lpodkalicki/tiny-metal-detector/README.md

# Tiny Metal Detector
ATtiny13 based PI (Pulse Induction) Metal Detector
