lpodkalicki/tiny-metal-detector/hardware/tiny_metal_detector_bottom.png

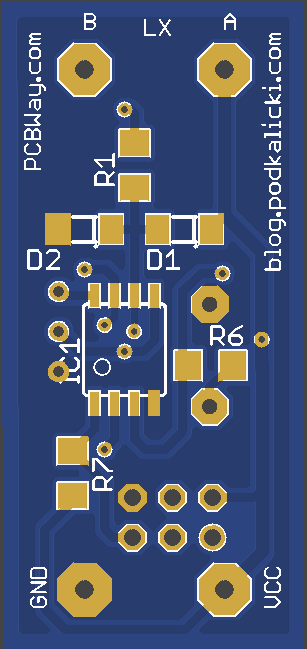
hardware/tiny_metal_detector_bottom.png
