lpodkalicki/tiny-metal-detector/hardware/tiny_metal_detector_top.png

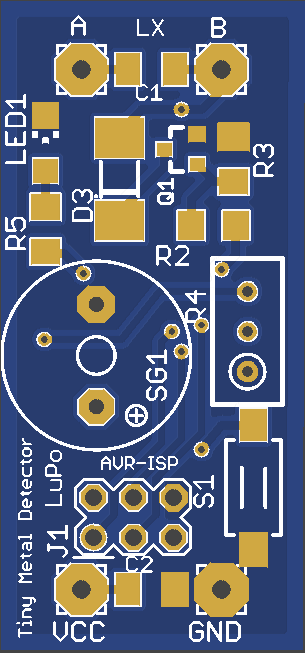
hardware/tiny_metal_detector_top.png
