lpodkalicki/tiny-metal-detector/hardware/tiny_metal_detector.pdf

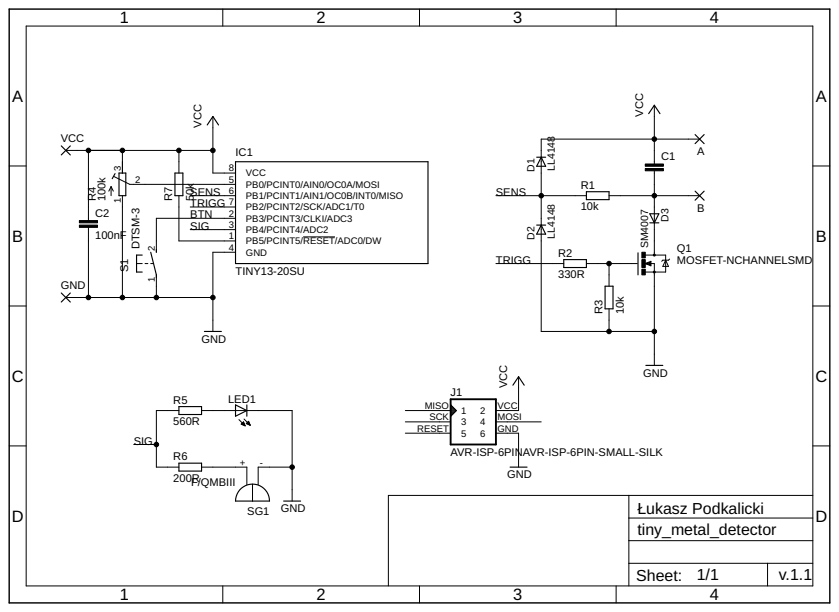
[picture p3: page 1]

AVR-ISP-6PINAVR-ISP-6PIN-SMALL-SILK
