lpodkalicki/tiny-metal-detector/hardware/tiny_metal_detector.brd

## EAGLE design hardware/tiny_metal_detector.brd (2019-03-14)

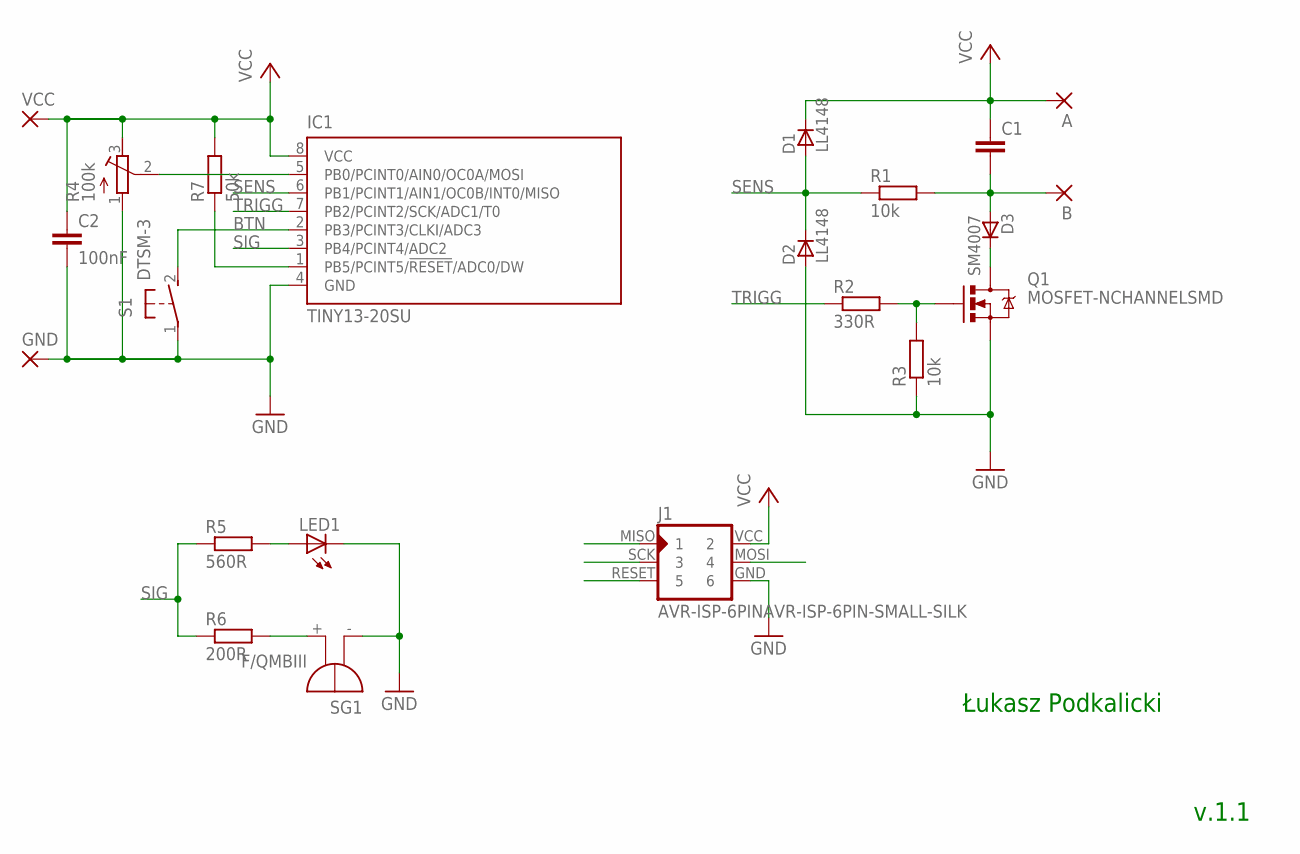
[picture p4: schematic tiny_metal_detector.sch]

Parts:
A: 3,17/1,1
B: 3,17/1,1
C1: C-EUC1206K; C1206K
C2: 100nF; C1206K
D1, D2: LL4148; SOD80_DO213AA_MINIMELF
D3: SM4007; MELF-MLL41_DO213AB
GND: 3,17/1,1
IC1: TINY13-20SU; 8S2
J1: AVR-ISP-6PINAVR-ISP-6PIN-SMALL-SILK; AVR-ISP-6PIN-SMAILL-SILK
LED1: LEDCHIPLED_1206; CHIPLED_1206
Q1: MOSFET-NCHANNELSMD; SOT23-3
R1, R3: 10k; R1206
R2: 330R; R1206
R4: 100k; RTRIM3296W
R5: 560R; R1206
R6: 200R; R1206
R7: 50k; R1206
S1: DTSM-3
SG1: F/QMBIII
VCC: 3,17/1,1

Connections:
BTN: IC1.2 (PB3/PCINT3/CLKI/ADC3), S1.2
GND: C2.2, D2.A, GND.1, IC1.4 (GND), J1.GND (6), LED1.C, Q1.2 (S), R3.1, R4.1 (A), S1.1, SG1.- (+)
MOSI: IC1.5 (PB0/PCINT0/AIN0/OC0A/MOSI), J1.MOSI (4), R4.2 (S)
unnamed: R6.2, SG1.+ (-)
unnamed: B.1, C1.2, D3.A, R1.2
unnamed: D3.C, Q1.3 (D)
unnamed: Q1.1 (G), R2.2, R3.2
unnamed: LED1.A, R5.2
RESET: IC1.1 (PB5/PCINT5/!RESET!/ADC0/DW), J1.RESET (5), R7.1
SENS: D1.A, D2.C, IC1.6 (PB1/PCINT1/AIN1/OC0B/INT0/MISO), J1.MISO (1), R1.1
SIG: IC1.3 (PB4/PCINT4/ADC2), R5.1, R6.1
TRIGG: IC1.7 (PB2/PCINT2/SCK/ADC1/T0), J1.SCK (3), R2.1
VCC: A.1, C1.1, C2.1, D1.C, IC1.8 (VCC), J1.VCC (2), R4.3 (E), R7.2, VCC.1

Notes on the sheet:
Łukasz Podkalicki
v.1.1

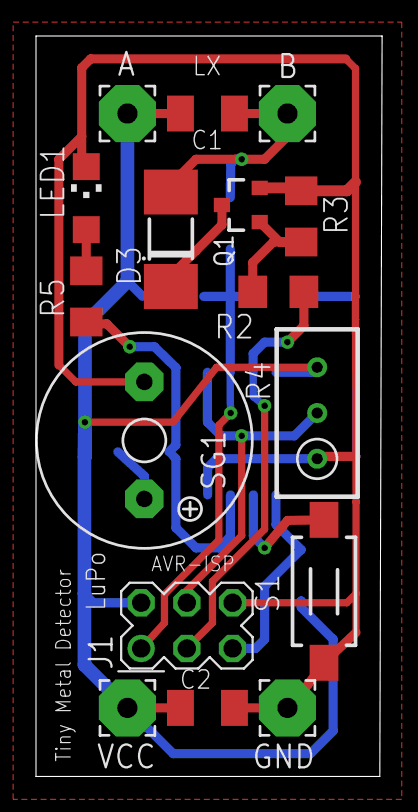
[picture p5: board tiny_metal_detector.brd from above]

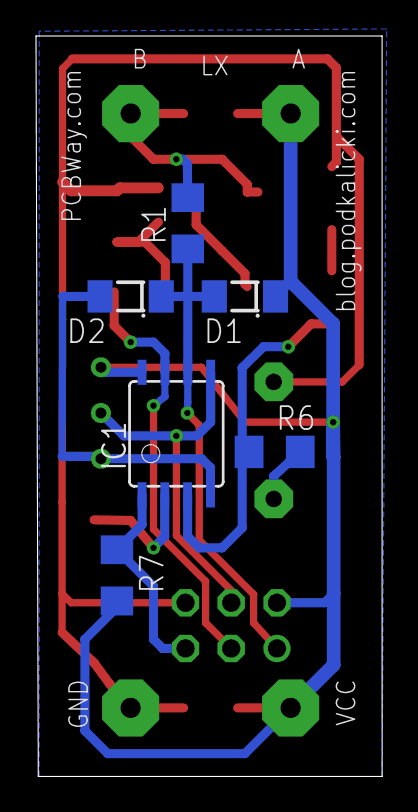
[picture p6: board tiny_metal_detector.brd from below]

Board: 2 copper layers, 19.2 x 41.1 mm, 22 parts (6 on the bottom side), 13 nets.
