lpodkalicki/tiny-metal-detector/(commit log)

2019-03-09 Add empty schematic.
    [tiny_metal_detector.sch]
2019-03-14 Add updated schematic, brd, gerber files and board images.
    [tiny_metal_detector.brd, tiny_metal_detector.sch]
